kalemena/drone-mower/README.adoc

= drone-mower
:hardbreaks:

This repository gathers notes which can be used to build a simple robot on wheels.

Usage of the robot is for now focused on the possible usage as mower.

But let's go step by step with stories.

As usual, learning is the key. If things in this repository work, then great; and if not, well this is good learning.

To build this Robot, we need:

* link:bom.adoc[BOM - buying few parts]
* link:3d-parts.adoc[Printing other parts]
* link:/stories/readme.adoc[Stories detailing each parts of building]

== References

* Documents

** link:https://www.dfrobot.com/blog-13511.html[DF-Robot blog explains RTK GPS]

* Existing mower projects (not entirely opensource)

** link:https://x-tech.online/2022/01/openmower/[Open Mower] && link:https://github.com/ClemensElflein/OpenMower[OpenMower Git project]
Concept focused on GPS-RTK.

** link:https://wiki.ardumower.de/index.php?title=Ardumower_Sunray[Ardumower]. 
This project has many details, including GPS-RTK capabilities. 
Downside is that this looks very bundled, hence complex monolith while this would be preferable to be based on interchangeable modules.

** link:https://repalmakershop.com/pages/mower-build-information[Repal Mower]
No compromise full 3D-printed mower.
Too ambitious to print everything.
Costly, yet not very modular.

** link:https://www.youtube.com/watch?v=ZhTGQARRAqk[Tondeuse solaire]
Interesting modular concept.
Not documented, but gives good hints on hardware links.

** link:https://www.slideshare.net/RITESHPATIL52/solar-based-grass-cutter-machine[Solar grass cutter] and link:https://nevonprojects.com/fully-automated-solar-grass-cutter/[Solar grass cutter (Kit)]
PDF explaining many aspects of building simple basic mower.
Kit DIY.

** link:https://www.open-electronics.org/a-robotic-lawn-mowers-powered-by-solar-energy-with-an-arduino-heart[Open Electronic model] has a store with minimal electronic board for a solar mower.
This design is the kind I'm looking for, modular enough.

** link:https://www.youtube.com/watch?v=KN7Gcw-nIkk[Arduino mower prototype]
Nice simple concept. But a video remains a video without much re-usability for others.

** link:https://www.instructables.com/Lawnmower-Robot/[Lawnmower-Robot]
Yet another Arduino mower. This time many details.

* Locomotion specifics:
** link:https://www.instructables.com/SCREW-DRIVE-RC-TANK[Screw drive RC tank] is moving surprisingly nice.
** link:https://www.veterobot.org/2015/06/building-robotics-ground-vehicle-part-1.html[Robotic vehicle motorisation explained]

* Vacuum Cleaner (have a lot in common with mowers)
** link:https://www.instructables.com/id/Build-Your-Own-Vacuum-Robot/[Vacuum cleaner - Instructable]

* Lidar (end up not interesting for mower, but cool)
** link:https://www.youtube.com/watch?v=6R3rVeY3Sgc[Wiring and details]
** link:http://www.tobias-weis.de/neato-xv-laser-scanner-lidar/[LIDAR RPi test]
** link:https://www.instructables.com/id/An-Autonomous-Rover[An autonomous Rover]
