kalemena/drone-mower/stories/15-GPS-RTK/readme.adoc

= GPS-RTK

GPS-RTK is the technology that enhance the GPS with centimeter accuracy.

== Discovery

SimpleRTK2B kit from link:https://www.ardusimple.com/[ArduSimple] is used in following tests.

=== Stage 1

Accuracy can be tested hooking up smartphone using following docs:

* link:https://www.ardusimple.com/how-to-use-ardusimple-products-with-android-smartphones-tablets/[Connect SimpleRTK2B to Android smartphone with USB]
* Connect NTRIP Caster on link:https://docs.centipede.fr/docs/centipede/3_connect_caster.html[Centipede (France)] or link:http://rtk2go.com[RTK2GO (world)] and select a caster close to your location using the map.

With a caster at about 10km, the result is surprising when looking at the map on Android app *SW Maps*.
With no doubt, location is precise at centimeter accuracy.
Standard GPS is of by 2-10 meters on the *SW Maps* application, while GPS-RTK gives somewhere under 30cm, right away.

There are few aspects to solve:

* Requires good internet access (WiFi or 4G)
* With Android app, this remains difficult to assess where we are in accuracy between 1 and 30cm

== References

.Papers
* link:https://rtklibexplorer.wordpress.com[RTKLib explorer]

.Centipede RTK
* link:https://docs.centipede.fr/[French shared NTRIP service]
** link:https://www.youtube.com/watch?v=dcWotLV3rF8[Teria RTK - explaination]
** link:https://hal.archives-ouvertes.fr/hal-03470820/document[Paper on usage in Coastal Morphodynamics Monitoring in Brittany]

.Hardware:
* link:https://www.elektor.fr/catalogsearch/result/?q=GPS-RTK[Sparkfun GPS-RTK] (link:https://learn.sparkfun.com/tutorials/gps-rtk-hookup-guide[tutorial])
* link:https://www.ardusimple.com/[ArduSimple]
** link:https://www.youtube.com/watch?v=VTCWRhXsgjo[simpleRTK2B to smartphone using BLE]
** link:https://www.ardusimple.com/how-to-use-ardusimple-products-with-android-smartphones-tablets/[SimpleRTK2B to Android smartphone with USB]

.French Farmers explained
* link:https://www.youtube.com/watch?v=utcBdppXC4c[Agri - explication]
* link:https://www.youtube.com/watch?v=-VMFGYpUTiI[GPS-RTK rover by farmer]
* link:https://www.youtube.com/watch?v=hkxunjCAMVs[GPS-RTK base by farmer]
