kalemena/drone-mower/3d-parts.adoc

= 3D modeling

Here are the parts used for prototyping.

Some parts are just for modeling view, and some are printed.

The approach is pragmatic: if easier and cheaper to buy, then buy! 
For example, the wheel and base support are bought for very few money.

== Full 3D view

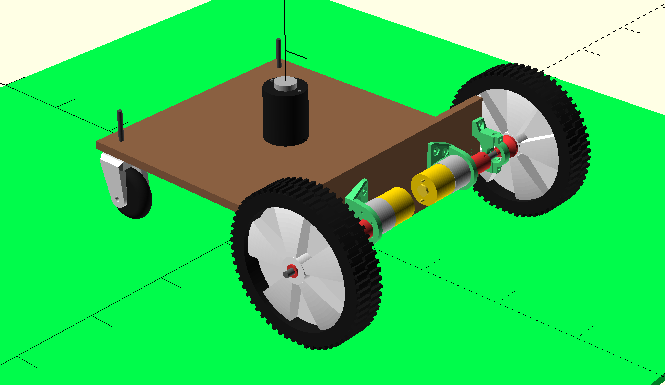
[picture p1: 3d-parts/mower-assembly.png]
Mower


== 3D parts

.Parts
[width="80%",options="header"]
|=========================================================
| Item | Printed | Image

| link:3d-parts/mowing-system-motor-xd-3420.scad[Motor XD-3420]
| No
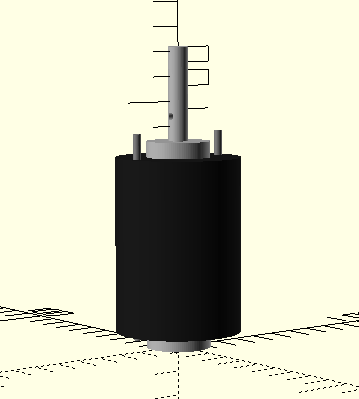
[picture p2: 3d-parts/mowing-system-motor-xd-3420.png]
motor xd-3420
| 

| link:3d-parts/gear-motor-30rpm.scad[Gear Motor 30RPM]
| No
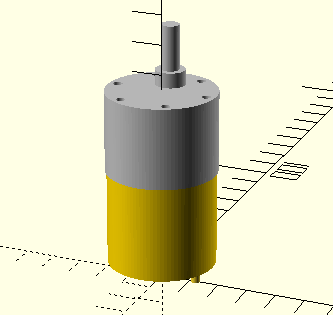
[picture p3: 3d-parts/gear-motor-30rpm.png]
Gear motor 30RPM
| 

| link:3d-parts/wheel-360.scad[Wheel swiveling]
| Partially (wheels is roller part)
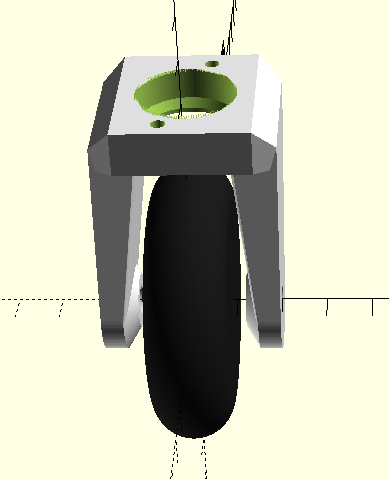
[picture p4: 3d-parts/wheel-360.png]
wheel 360
| 

| link:[Wheel gear]
| No (from the local store)
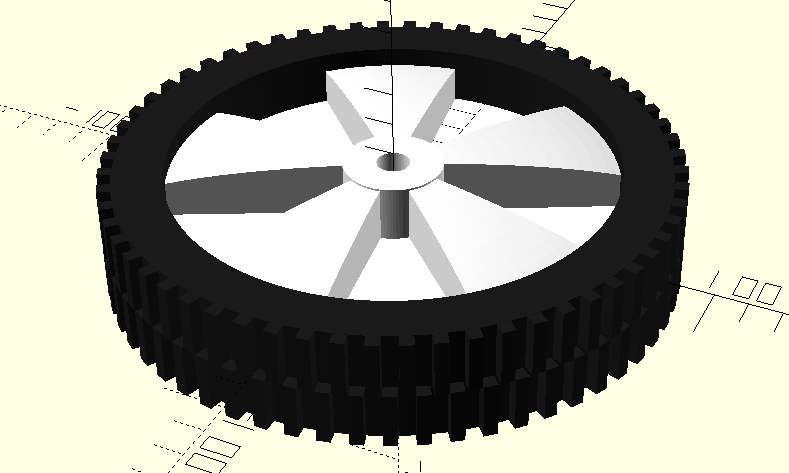
[picture p5: 3d-parts/gear-wheel.png]
Gear wheel
| 

| link:3d-parts/mowing-system-disc-nylon.scad[Mowing System Disc]
| No
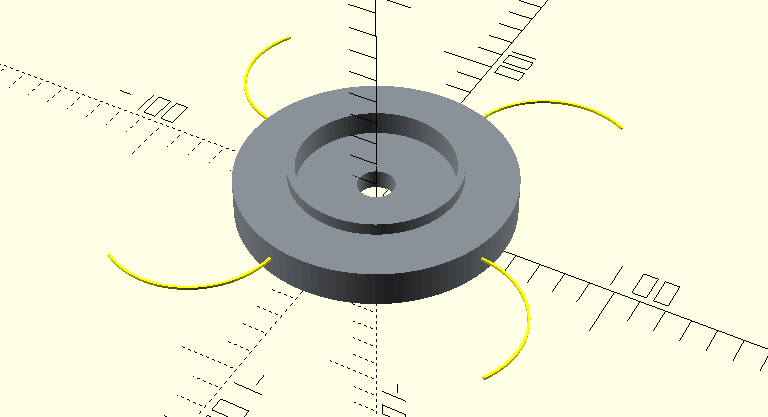
[picture p6: 3d-parts/mowing-system-disc-nylon.png]
Mowing System Disc
| 

| link:3d-parts/gear-parts.scad[Gear parts]
(bearing to support module, shaft coupling, motor support, wheel axle adaptor)
| Yes (motor, axle and wheel appart)
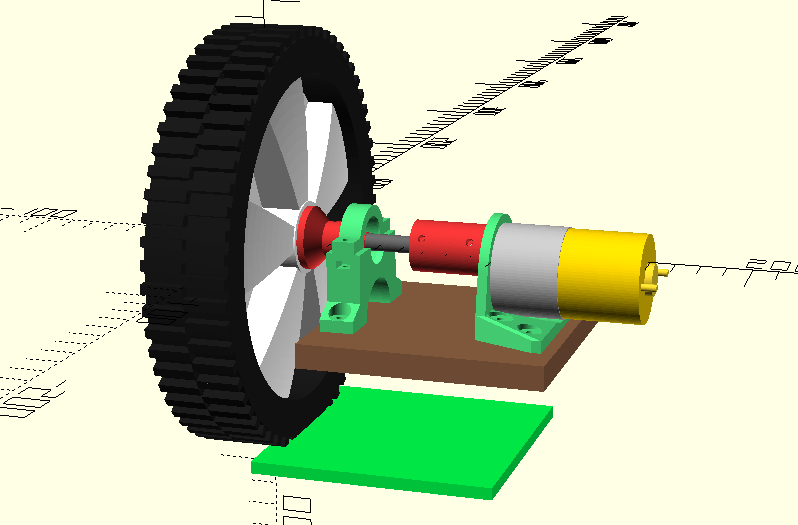
[picture p7: 3d-parts/gear-parts.png]
Gear parts
| 

| link:[Mowing System parts]
(support, axle to disc adaptor)

| Yes (Motor appart)
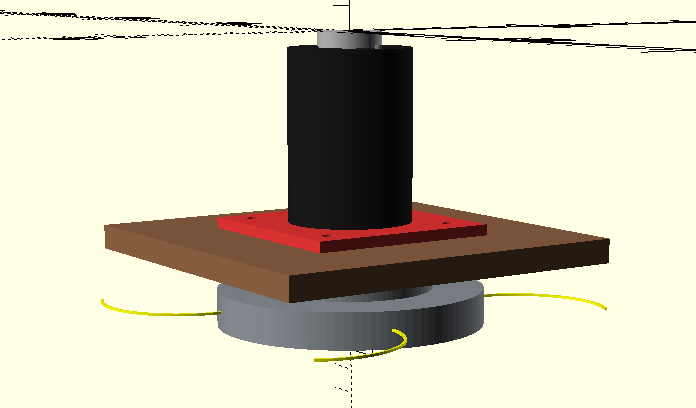
[picture p8: 3d-parts/mowing-system-parts.png]
Mowing System parts
| 

|=========================================================

== References

Keyword: "ball caster", "swiveling wheel"

* link:https://www.thingiverse.com/thing:16627/files[tooth]

* link:https://www.thingiverse.com/thing:21486[wheel]

* link:https://www.thingiverse.com/thing:24071[]

* link:https://www.thingiverse.com/thing:617055[Sonar servo-mount]
