kalemena/drone-mower/3d-parts/stl/gear-parts-8mm-axle-200mm-wheel-int.stl

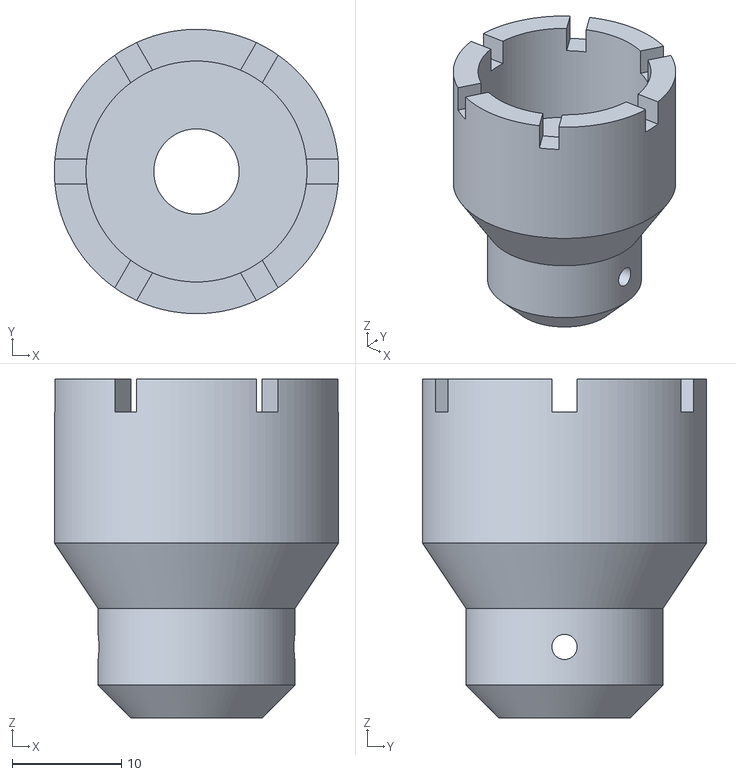
[picture p9: CAD file, 2020-09-05]
3d-parts/stl/gear-parts-8mm-axle-200mm-wheel-int.stl
26.0 x 26.0 x 31.0
