kalemena/drone-mower/3d-parts/stl/gear-parts-8mm-axle-200mm-wheel-ext.stl

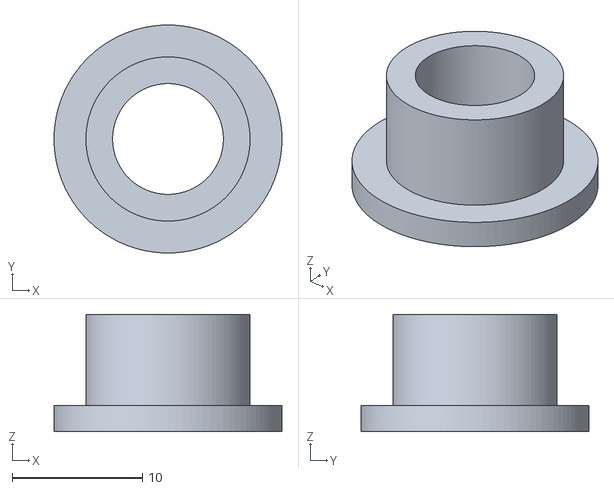
[picture p10: CAD file, 2020-09-04]
3d-parts/stl/gear-parts-8mm-axle-200mm-wheel-ext.stl
17.5 x 17.5 x 9.00
