kalemena/drone-mower/3d-parts/stl/sensors-sr04-mount.stl

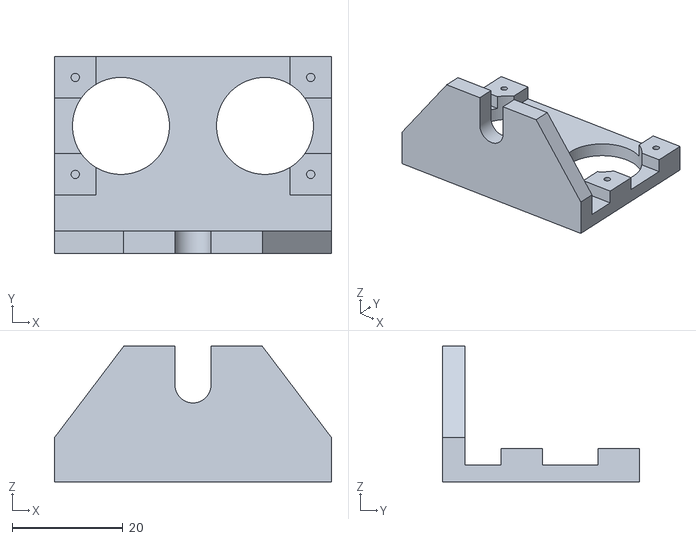
[picture p11: CAD file, 2019-09-13]
3d-parts/stl/sensors-sr04-mount.stl
50.0 x 35.5 x 24.5
