kalemena/drone-mower/3d-parts/stl/gear-parts-8mm-int-wheel.stl

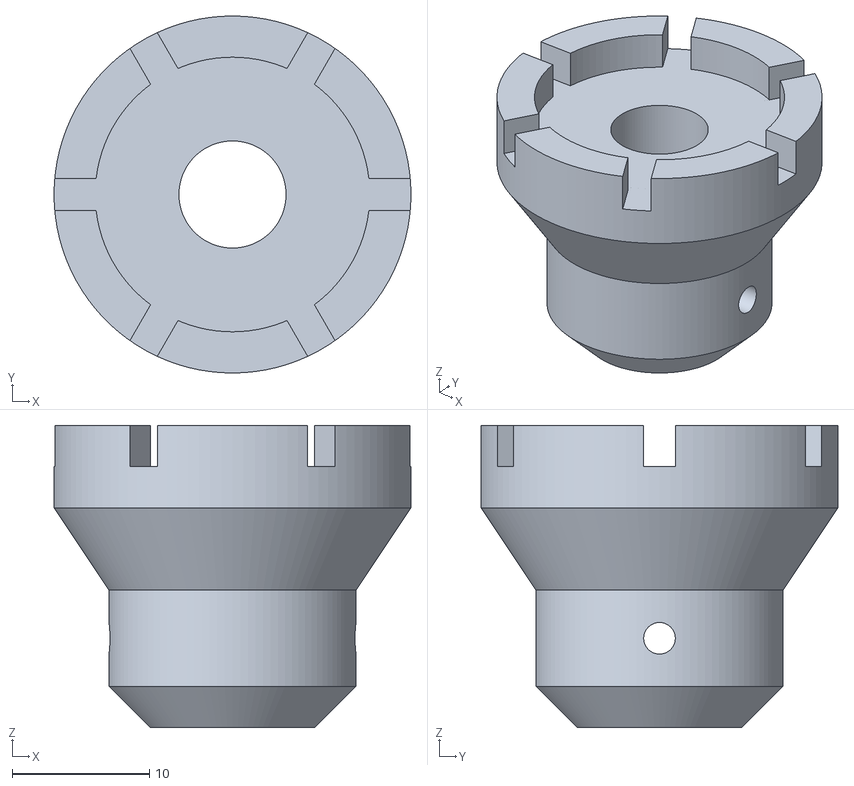
[picture p12: CAD file, 2019-09-08]
3d-parts/stl/gear-parts-8mm-int-wheel.stl
26.0 x 26.0 x 22.0
