kalemena/drone-mower/3d-parts/stl/gear-parts-8mm-ext-bearing-holder-top.stl

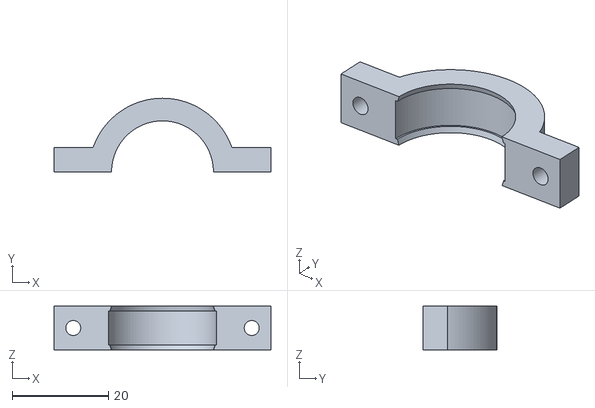
[picture p13: CAD file, 2019-09-04]
3d-parts/stl/gear-parts-8mm-ext-bearing-holder-top.stl
45.0 x 15.2 x 9.10
