kalemena/drone-mower/3d-parts/stl/gear-parts-motor-support.stl

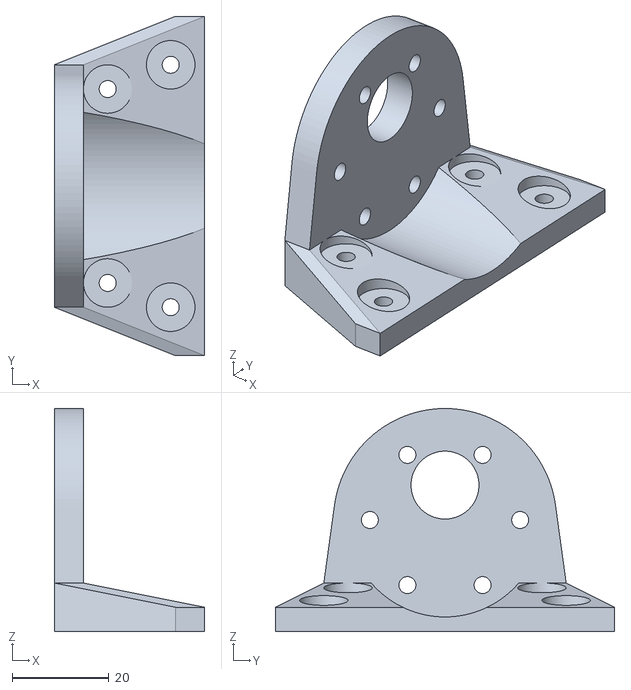
[picture p14: CAD file, 2019-09-04]
3d-parts/stl/gear-parts-motor-support.stl
31.0 x 70.0 x 46.0
