kalemena/drone-mower/3d-parts/stl/mowing-system-parts-motor-support.stl

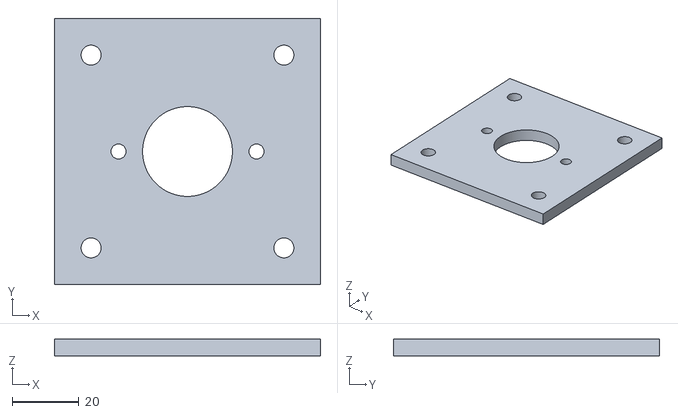
[picture p15: CAD file, 2019-09-04]
3d-parts/stl/mowing-system-parts-motor-support.stl
80.0 x 80.0 x 5.00
