kalemena/drone-mower/3d-parts/stl/gear-parts-8mm-axle-to-6mm-motor-adapter.stl

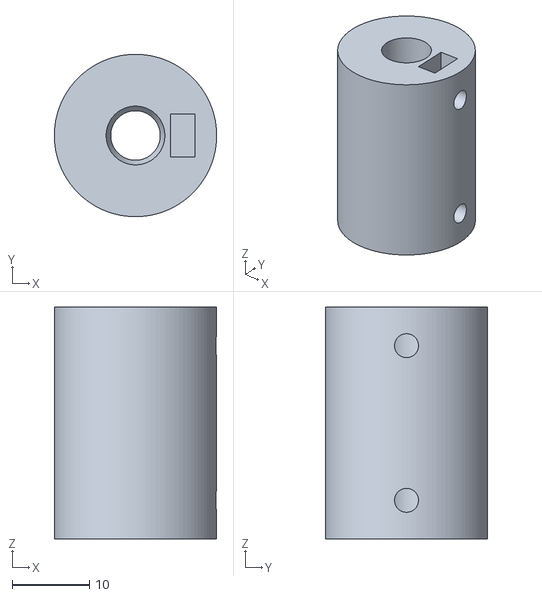
[picture p16: CAD file, 2019-09-04]
3d-parts/stl/gear-parts-8mm-axle-to-6mm-motor-adapter.stl
21.0 x 21.0 x 30.0
