kalemena/drone-mower/3d-parts/stl/gear-parts-8mm-ext-bearing-holder-bottom.stl

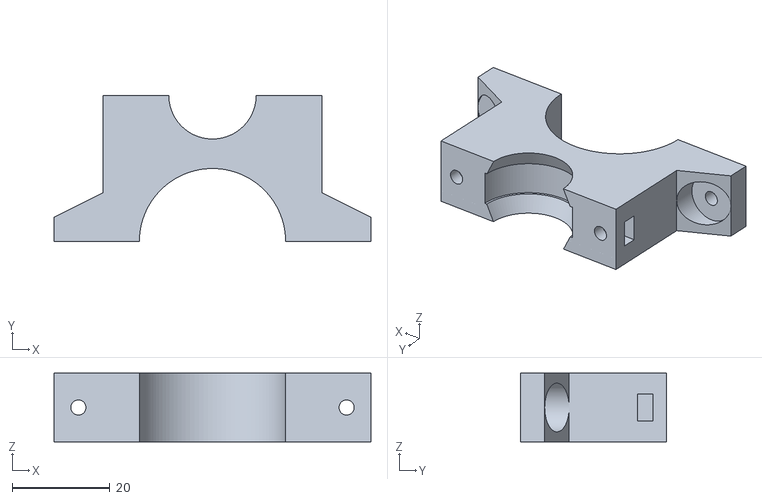
[picture p17: CAD file, 2019-09-04]
3d-parts/stl/gear-parts-8mm-ext-bearing-holder-bottom.stl
65.0 x 30.0 x 14.1
