kalemena/drone-mower/3d-parts/stl/gear-parts-8mm-ext-wheel.stl

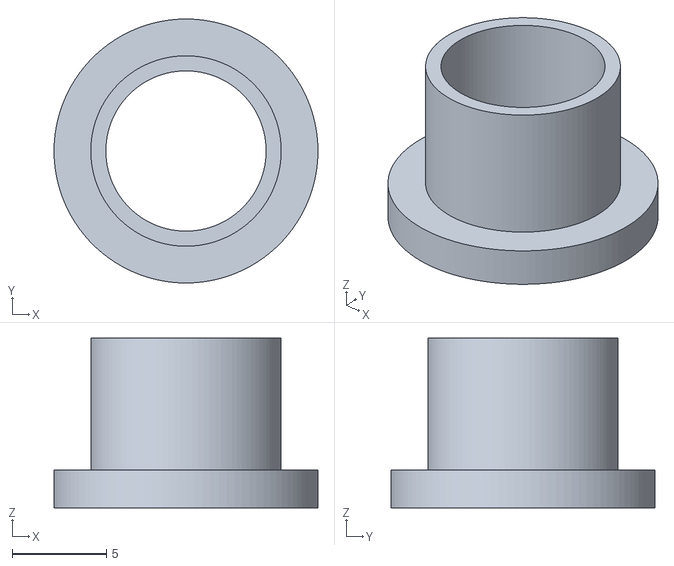
[picture p18: CAD file, 2019-09-04]
3d-parts/stl/gear-parts-8mm-ext-wheel.stl
14.0 x 14.0 x 9.00
