kalemena/drone-mower/3d-parts/stl/mowing-system-parts-axle-adaptor.stl

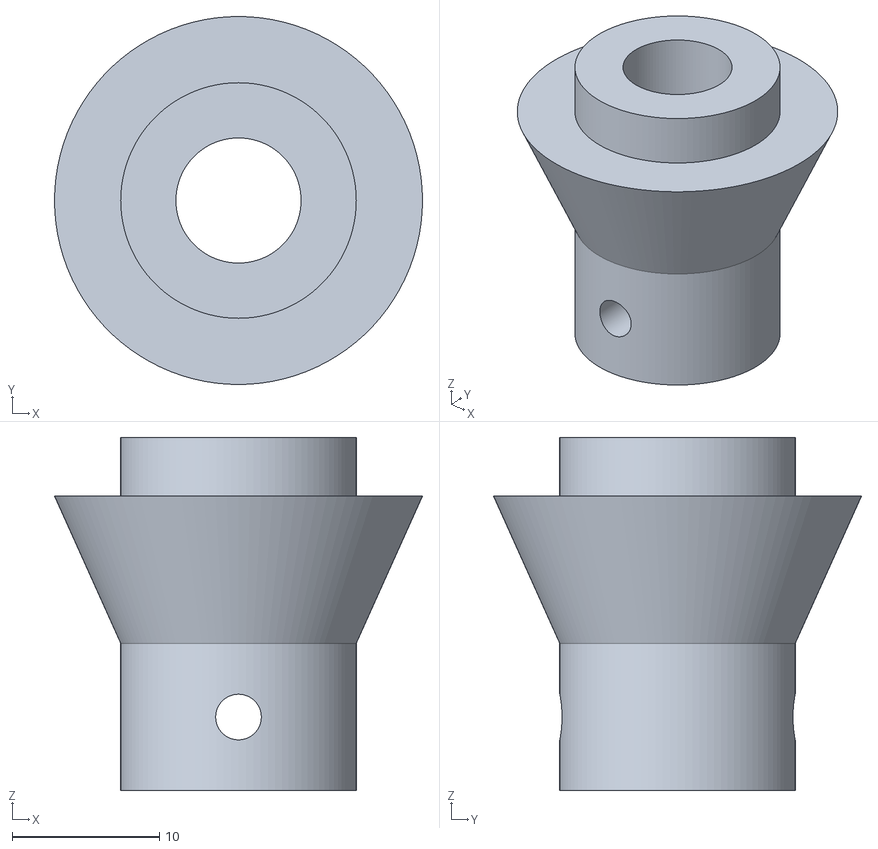
[picture p19: CAD file, 2019-09-04]
3d-parts/stl/mowing-system-parts-axle-adaptor.stl
25.0 x 25.0 x 24.0
