kalemena/drone-mower/(list of files, cad)

Other CAD files:
3d-parts/gear-wheel-200mm.scad
3d-parts/gear-parts-200mm.scad
