kalemena/drone-mower/stories/09-L298N-Test/README.adoc

= Motors driver test

Motor driver is L298N.

This test will hook the motors and alternate rotation Clockwise, CounterClockwise.

== BOM

Motor Driver L298N

12v motors

== Wiring

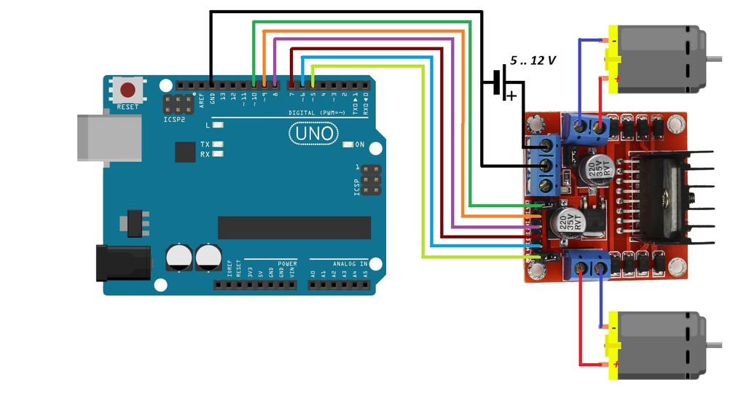
[picture p24: stories/09-L298N-Test/L298N-wiring.jpg]
Wiring


== Code

link:/stories/09-L298N-Test/L298N-test/L298N-test.ino[Example]

== References

link:https://howtomechatronics.com/tutorials/arduino/arduino-dc-motor-control-tutorial-l298n-pwm-h-bridge/[Example L298N]
