kalemena/drone-mower/stories/03-relay-test/README.adoc

= Relay

== BOM

Arduino relay 5v

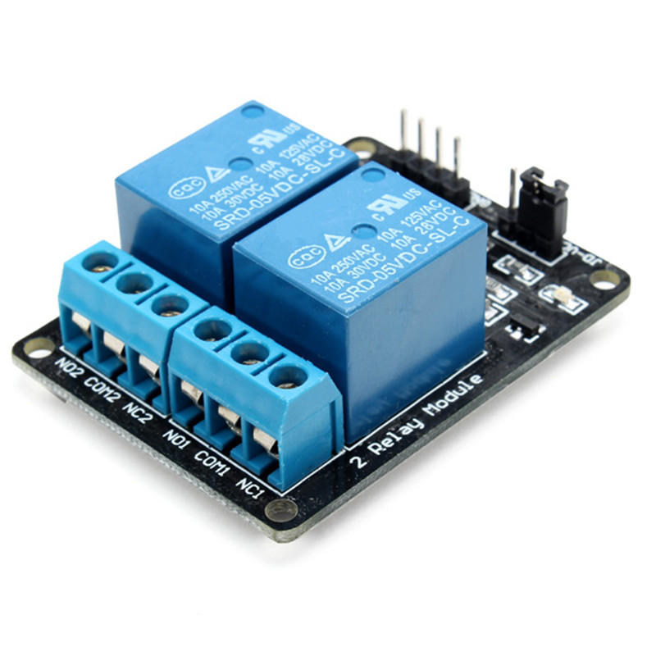
[picture p30: stories/03-relay-test/relay.jpg]
Relay 5v


== Wiring

.Table Hardware Connections
|===
|Arduino |Relay Board

|5V    |   VCC
|12    |   IN1
|GND   |   GND
|===

== Code

link:relay-test[Example]
