kalemena/drone-mower/stories/02-motors-XD-3420-test/README.adoc

= Motor - XD-3420

== BOM

Motor Driver BTS7960 43A

== Wiring

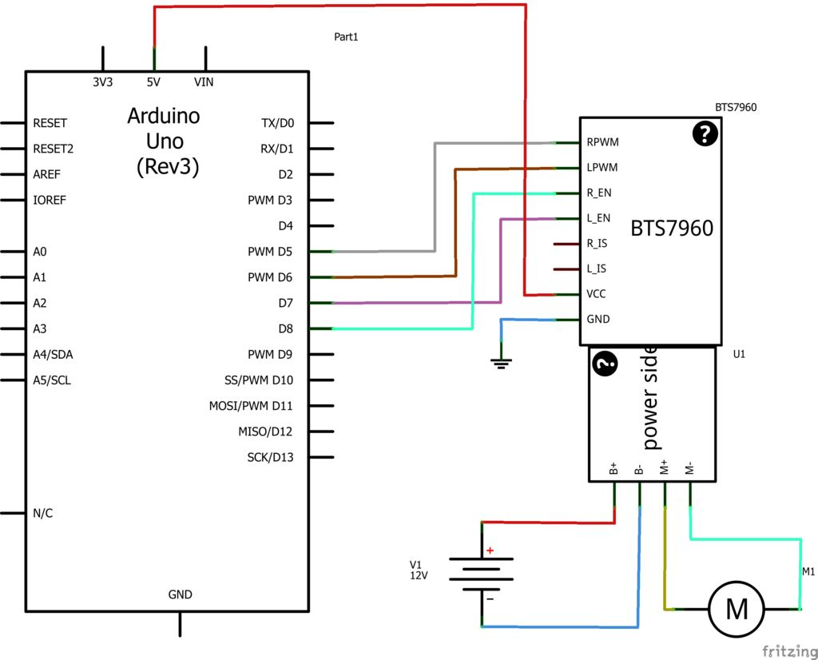
[picture p32: stories/02-motors-XD-3420-test/Motor-Driver-BTS7960-43A-wiring.jpg]
Motor Driver BTS7960 43A wiring


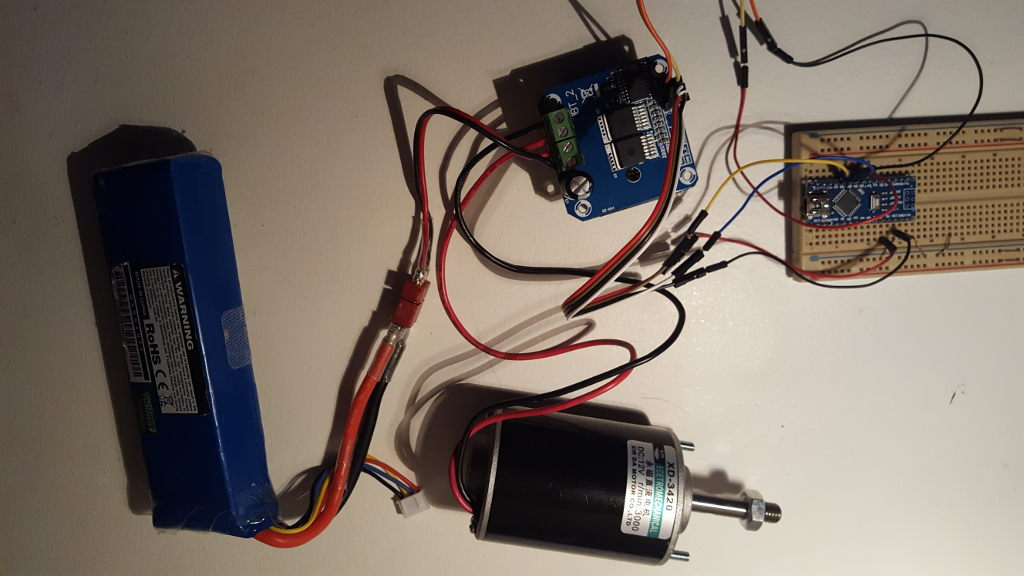
[picture p33: stories/02-motors-XD-3420-test/motor-xd-3420.jpg]
Wired with batteries


== Code

link:motor-xd-3420-test[Example]

== References

link:https://www.instructables.com/id/Motor-Driver-BTS7960-43A/[Motor Driver BTS7960 43A]
