kalemena/drone-mower/(commit log)

2019-06-21 Story: sonar
2019-06-22 Story: motors for blades cutting grass
2019-06-22 Updated sonar details
2019-06-23 Story relay test
2019-06-24 Story: sensor rain drop
2019-06-26 Story: current sensor
2019-06-27 Story motors and current measure
2019-06-28 Story: I2C use case
2019-06-30 Story: motor gear l298n
2019-07-01 Story: RF controlled motors
2019-07-02 Story: RC all motors
2019-07-07 Add 3d parts links
    [HighlyConfigurableWheelv1.33.scad, wheel-360.scad]
2019-07-08 3d: add gear motor support
    [gear-motor-support.scad]
2019-07-10 full change of motor gear support
    [gear-motor-support.scad]
2019-07-11 re-design gear support
    [gear-motor-support.scad]
2019-07-12 Wheel sample 80mm
    [HighlyConfigurableWheelv1.33.scad, HighlyConfigurableWheelv1.stl, gear-motor-support.stl]
2019-07-13 update sample code with button to activate motors
2019-07-14 Add 360 wheel (based on roller wheel)
    [wheel-360.scad, wheel-360.stl]
2019-07-17 update swiveling wheel 3d
    [wheel-360.scad, wheel-360.stl]
2019-07-20 update for esp32
2019-07-21 update swiveling wheel
    [wheel-360.scad, wheel-360.stl]
2019-07-24 Update wheel for new print
    [wheel-360.scad]
2019-08-03 restructure stories
    [wheel-360.stl]
2019-08-04 add 3d part XD-3420
    [motor-xd-3420.scad, wheel-360.scad]
2019-08-05 3d parts gear motor model
    [motor-gear-30rpm.scad]
2019-08-08 crappy 3d modeling
    [motor-xd-3420.scad, mower.scad]
2019-08-11 add BOM
2019-08-12 3d parts add wheel gear sample
    [wheel-gear.scad]
2019-08-13 3d parts - add motor adapter
    [motor-cut-adapter-15.scad, motor-cut-adapter-15.stl, mower.scad, wheel-gear.scad, wheel-gear.stl]
2019-08-14 Add few items to BOM
2019-08-15 add image for 3d parts
    [motor-cut-adapter.scad, motor-cut-adapter.stl, motor-gear-support.scad, motor-gear-support.stl]
2019-08-19 3d parts add motor cut piece
    [motor-cut-adapter.scad]
2019-08-20 3d parts - motor cut support
    [motor-cut-support.scad, motor-xd-3420.scad]
2019-08-21 3d parts - update wheel gear
    [wheel-gear.scad, wheel-gear.stl]
2019-08-22 3d parts - add links and colorize parts
    [motor-cut-support.scad, motor-cut-support.stl, motor-xd-3420.scad, mower.scad, wheel-gear.scad]
2019-08-23 3d parts - update with colors
    [motor-gear-30rpm.scad, mower.scad, wheel-360.scad]
2019-08-24 3d parts - update motor cut parts
    [motor-cut-disc.scad, motor-cut-support.scad, motor-cut-support.stl, mower.scad]
2019-08-25 3d parts - update motor gear adapter
    [motor-gear-adapter.scad]
2019-08-26 3d parts: updates tune
    [motor-cut-adapter.scad, motor-gear-adapter.scad]
2019-08-27 3d parts - update shaft coupling for 7mm to 6mm
    [motor-gear-adapter.scad]
2019-08-28 3d parts - update bearingaxle fix
    [motor-gear-adapter.scad]
2019-08-29 3d parts : fine tune M3 fix and start bearing mount
    [motor-gear-adapter.scad]
2019-08-30 3d parts: put gear things together
    [motor-cut-adapter.scad, motor-gear-adapter.scad, motor-gear-support.scad, wheel-gear.scad]
2019-08-31 3d parts - renaming for understanding + update bearing support
    [HighlyConfigurableWheelv1.33.scad, HighlyConfigurableWheelv1.stl, gear-motor-30rpm.scad, gear-parts.scad, gear-wheel.scad, motor-cut-adapter.stl, motor-cut-support.stl, motor-gear-adapter.scad]
2019-09-01 3d parts: update first prototype
    [gear-parts.scad, mower-assembly.scad, mowing-system-disc-nylon.scad, mowing-system-parts.scad, mowing-system-support.scad]
2019-09-02 3d parts: update proto design
    [gear-parts.scad, mower-assembly.scad, wheel-360.scad]
2019-09-03 3d parts: update proto assembly
2019-09-04 3d parts: add printed STL
    [gear-parts-8mm-axle-to-6mm-motor-adapter.stl, gear-parts-8mm-ext-bearing-holder-bottom.stl, gear-parts-8mm-ext-bearing-holder-top.stl, gear-parts-8mm-ext-wheel-bearing-addon.stl, gear-parts-8mm-ext-wheel.stl, gear-parts-8mm-int-wheel.stl, gear-parts-motor-support.stl, mowing-system-parts-axle-adaptor.stl]
2019-09-07 3d parts: update wheel fixing
    [gear-parts-8mm-ext-wheel-bearing-addon.stl, gear-parts-8mm-int-wheel.stl, gear-parts.scad]
2019-09-08 3d parts: fine tune gearing
    [gear-parts-8mm-int-wheel.stl, gear-parts.scad, mowing-system-parts.scad]
2019-09-09 Update prototype
2019-09-10 Story sensors: update sketch with relays
2019-09-13 3d-parts: add sr04 support
    [sensors-sr04-mount.scad, sensors-sr04-mount.stl]
2019-09-15 Test 3 sonars together
2020-09-04 3d parts: update for bigger wheel
    [gear-wheel-175mm.scad, gear-wheel-200mm.scad]
2020-09-04 3d parts: wheel 175mm parts
    [gear-parts-175mm.scad]
2020-09-04 3d parts: wheel 200mm parts
    [gear-parts-200mm.scad, gear-parts-8mm-axle-200mm-wheel-ext.stl]
2020-09-05 3d parts: fix wheel 175mm
    [gear-parts-175mm.scad]
2022-05-07 BOM update - remove dead links
2022-05-07 BOM update
